uchitha-induranga/GAS-SENSOR/diag1.png

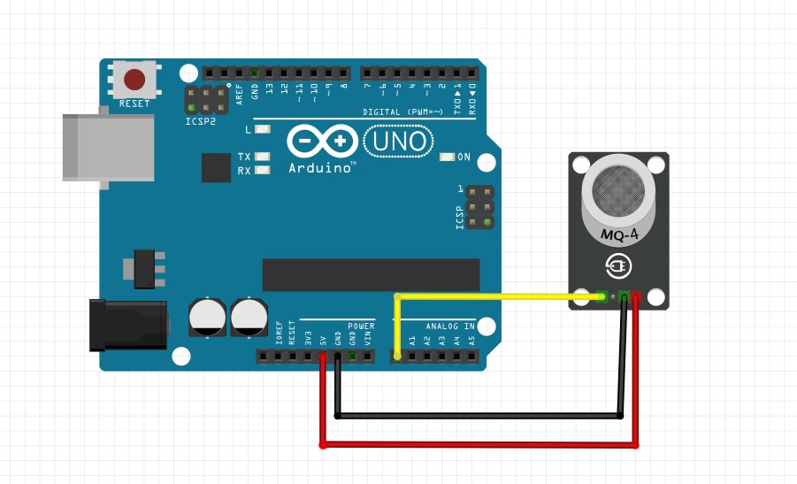
diag1.png
