uchitha-induranga/GAS-SENSOR/diag2.png

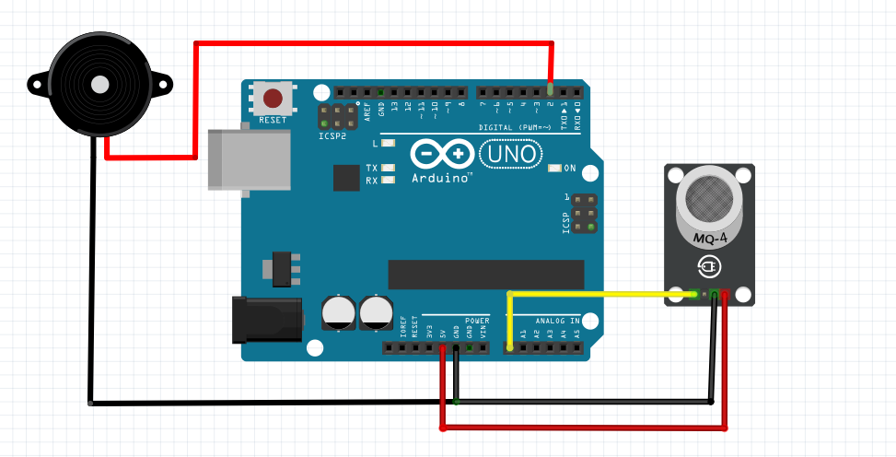
diag2.png
