uchitha-induranga/GAS-SENSOR/diag3.png

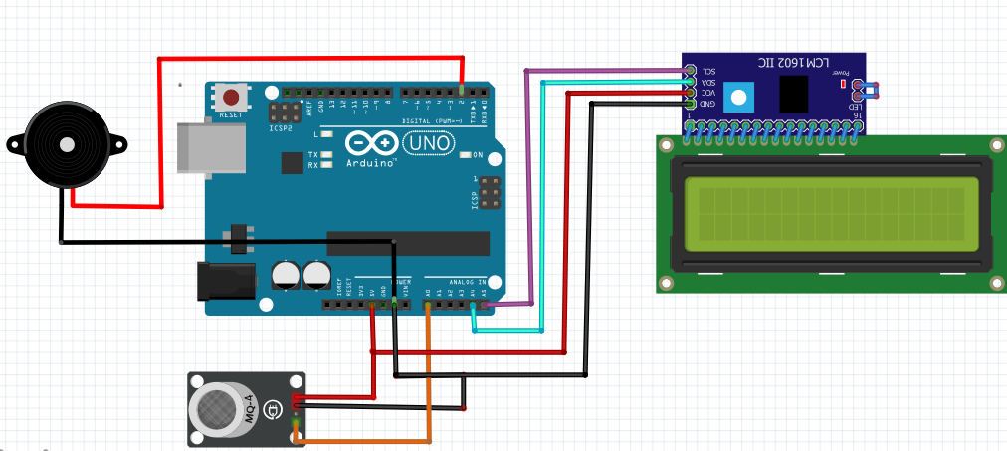
diag3.png
